dylanbailes/MPCTorqueControl/README.md

# SEA-MPC: torque control for a series-elastic actuator



A robotics controls project connecting mechanical compliance, system
identification, constrained model predictive control, and learned disturbance
compensation. A two-mass actuator model provides a reproducible environment
for comparing PID, MPC, and MPC with feedforward before hardware bring-up.

**Status:** simulation experiments and portable C control modules are
implemented. STM32 board integration and physical validation are in progress.
All results below are simulated; 2 kHz is the modeled torque-loop rate, not a
measured embedded execution rate. The firmware entry point is an integration
scaffold. See [remaining work](firmware/README.md).

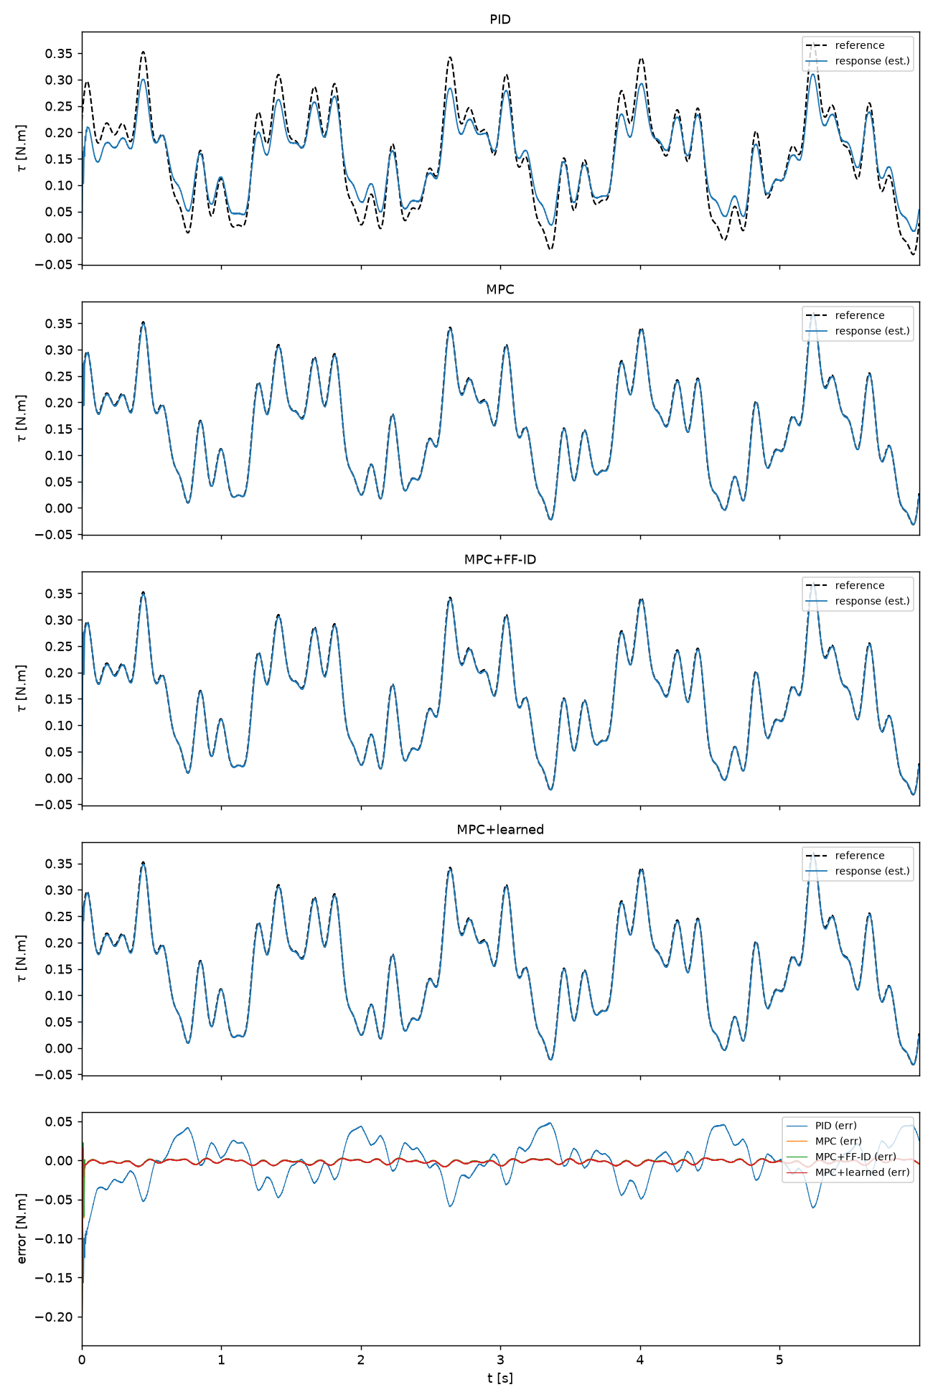
[picture p1: results/plots/tracking_smooth.png]
Simulated torque tracking for PID, MPC, and learned feedforward


## What the project demonstrates

- **Mechanical modeling:** a motor and load coupled by a torsion spring,
  with torque estimated from differential deflection.
- **Control design:** exact discretization, condensed MPC, current and
  first-command slew constraints, and a warm-started ADMM solver.
- **Identification:** spring calibration, integrated least squares, and a
  frequency-domain inertia cross-check.
- **Learning:** a compact residual model with causal lag features, held-out
  evaluation, and comparison against simpler friction compensation.
- **Embedded implementation:** portable C control modules and generated
  model constants, checked against the Python implementation on a host.

```text
torque reference -> PID / MPC -> optional feedforward -> current command
                                                        |
                         motor -> torsion spring -> load
                           |                       |
                           +--- angle feedback ----+
                              torque = ks * (θm - θl)
```

## Simulation results

The published experiment uses the selected 4015 motor parameter scenario
and a blocked-output fixture. [Results and limitations](docs/RESULTS.md)
define the measurement windows, configuration, and comparison conditions.
The table comes from [results/results.json](results/results.json).

<!-- RESULTS_TABLE_START -->
| Metric [mN·m] | PID | MPC | MPC + learned FF |
|---|---:|---:|---:|
| Smooth tracking RMS, latter half | 24.77 | 2.98 | 2.98 |
| Smooth tracking RMS, full run | 27.32 | 7.10 | 6.76 |
| Edge-rich tracking RMS, full run | 32.86 | 10.66 | 10.17 |
| Disturbance mean absolute error, steady window | 9.61 | 1.79 | 1.17 |
<!-- RESULTS_TABLE_END -->

The principal result is the improvement from model-based torque control.
Learned feedforward is an experiment: its benefit depends on the reference,
model error, and available current authority. A high residual-model R² does
not establish hardware performance or safe human interaction.

## Run it locally

Use Python 3.11 or 3.12 from the repository root. For the exact Python 3.12
environment used for the published snapshot, install `requirements-lock.txt`
instead of `requirements.txt`.

```bash
python -m venv .venv
# macOS / Linux:
source .venv/bin/activate
# Windows PowerShell: .\.venv\Scripts\Activate.ps1
python -m pip install -r requirements.txt
python -m pytest -q
python hardware/spring_design.py
```

Tests include host C compilation and Python/C MPC comparisons when GCC or
Clang is available. These checks run in GitHub Actions; without a local C
compiler they are explicitly skipped. Set `CC` to select a compiler.

Reproduce the published 4015 scenario (allow several minutes):

```bash
python -m sim.run_experiments --r 4.8 --l 0.0026 --kt 0.1562 --jm 0.00003 --u-max 3 --n 30 --out-dir results/scratch/4015
```

The default command runs a separate nominal plant scenario. `--fast`
shortens the experiments and produces different metrics. Scratch outputs
are ignored so exploratory runs do not overwrite the published evidence.
See [the results guide](results/README.md) for exports and provenance.
Website-ready charts in PNG/SVG, with light and dark themes, are available in
[the visuals gallery](results/website/README.md).

## Read the implementation

| Location | Purpose |
|---|---|
| [model/mpc.py](model/mpc.py), [model/qp.py](model/qp.py) | Prediction model, constrained controller, solvers |
| [learn/system_id.py](learn/system_id.py) | Calibration and inertia identification |
| [learn/residual.py](learn/residual.py) | Residual fitting, causal history, C export |
| [sim/bench.py](sim/bench.py) | Shared experiment harness and current budget |
| [test/](test/) | Numerical, control, and host firmware regression tests |
| [firmware/](firmware/README.md) | STM32 control modules and integration gaps |
| [hardware/](hardware/README.md) | Spring sizing, planned parts, CAD references |
| [model/matlab/](model/matlab/README.md) | Independent MATLAB formulations |

Start with [the design](docs/DESIGN.md), then inspect the controller and
[the results](docs/RESULTS.md). [Current limitations and next steps](docs/STATUS.md)
separate completed work from planned validation. The [16-week build plan](docs/plan/README.md)
and [research proposal](docs/PAPER_PITCH.md) are supporting planning documents.

## Contributing and license

See [CONTRIBUTING.md](CONTRIBUTING.md) for verification and experiment changes.
Original code and documentation use the [MIT license](LICENSE).
[Third-party material](THIRD_PARTY.md) retains its own terms; downloaded CAD
references are excluded from the public source.
See [the public-release review](docs/PUBLIC_RELEASE.md) for completed checks
and the remaining publication steps.
