dylanbailes/MPCTorqueControl/hardware/cad/inertial_disk/as_modeled/recommended_sweep.csv

config | radius_mm | A_per_face | B_per_face | mass_washer_count | retention_kits | carrier_weights_kits_mass_g | max_grip_mm | J_estimate_kg_m2 | locked_motor_load_mode_hz
BARE | 0 | 0 | 0 | 0 | 0 | 26.145306700259816 | 14.0 | 2.631584639114005e-05 | 31.024976434155906
R25-S00 | 25 | 0 | 0 | 0 | 8 | 106.14530670025982 | 14.0 | 7.631584639114005e-05 | 18.218506380332695
R25-S01 | 25 | 1 | 0 | 8 | 8 | 128.66844000897666 | 17.2 | 9.141312832633971e-05 | 16.646228271465326
R25-S02 | 25 | 1 | 1 | 16 | 8 | 151.19157331769347 | 17.2 | 0.00010651041026153936 | 15.421410682794399
R25-S03 | 25 | 2 | 1 | 24 | 8 | 173.7147066264103 | 20.4 | 0.000121607692196739 | 14.432434934911253
R25-S04 | 25 | 2 | 2 | 32 | 8 | 196.23783993512717 | 20.4 | 0.00013670497413193866 | 13.612189082800725
R25-S05 | 25 | 3 | 2 | 40 | 8 | 218.76097324384398 | 23.6 | 0.0001518022560671383 | 12.917575799038481
R25-S06 | 25 | 3 | 3 | 48 | 8 | 241.28410655256084 | 23.6 | 0.00016689953800233797 | 12.319485320460918
R25-S07 | 25 | 4 | 3 | 56 | 8 | 263.80723986127765 | 26.8 | 0.00018199681993753762 | 11.797452349140194
R25-S08 | 25 | 4 | 4 | 64 | 8 | 286.3303731699945 | 26.8 | 0.00019709410187273728 | 11.336612904210384
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
