dylanbailes/MPCTorqueControl/hardware/cad/inertial_disk/as_modeled/run_manifest.csv

run_id | repeat_block | config | A_per_face | B_per_face | radius_mm | J_estimate_kg_m2 | J_identified_kg_m2 | controller_mode | excitation_id | temperature_C | data_filename | notes
as_modeled-001 | 1 | R25-S05 | 3 | 2 | 25 | 0.0001518022560671383
as_modeled-002 | 1 | R25-S13 | 7 | 6 | 25 | 0.0002725805115487355
as_modeled-003 | 1 | R25-S12 | 6 | 6 | 25 | 0.0002574832296135359
as_modeled-004 | 1 | R25-S10 | 5 | 5 | 25 | 0.00022728866574313659
as_modeled-005 | 1 | R25-S03 | 2 | 1 | 25 | 0.000121607692196739
as_modeled-006 | 1 | R25-S19 | 10 | 9 | 25 | 0.00036316420315993345
as_modeled-007 | 1 | R25-S00 | 0 | 0 | 25 | 7.631584639114005e-05
as_modeled-008 | 1 | R25-S21 | 11 | 10 | 25 | 0.00039335876703033276
as_modeled-009 | 1 | R25-S18 | 9 | 9 | 25 | 0.00034806692122473377
as_modeled-010 | 1 | R25-S01 | 1 | 0 | 25 | 9.141312832633971e-05
as_modeled-011 | 1 | R25-S22 | 11 | 11 | 25 | 0.0004084560489655324
as_modeled-012 | 1 | R25-S14 | 7 | 7 | 25 | 0.0002876777934839352
as_modeled-013 | 1 | R25-S23 | 12 | 11 | 25 | 0.00042355333090073207
as_modeled-014 | 1 | R25-S02 | 1 | 1 | 25 | 0.00010651041026153936
as_modeled-015 | 1 | R25-S15 | 8 | 7 | 25 | 0.00030277507541913483
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
