dylanbailes/MPCTorqueControl/hardware/cad/inertial_disk/compact/recommended_sweep.csv

config | radius_mm | A_per_face | B_per_face | mass_washer_count | retention_kits | carrier_weights_kits_mass_g | max_grip_mm | J_estimate_kg_m2 | locked_motor_load_mode_hz
BARE | 0 | 0 | 0 | 0 | 0 | 17.8714951904302 | 12.0 | 2.2119203033450878e-05 | 33.84039269675885
R26-S00 | 26 | 0 | 0 | 0 | 8 | 97.8714951904302 | 12.0 | 7.619920303345087e-05 | 18.23244520808121
R26-S01 | 26 | 1 | 0 | 8 | 8 | 120.39462849914703 | 15.2 | 9.244516476739508e-05 | 16.55305016543145
R26-S02 | 26 | 1 | 1 | 16 | 8 | 142.91776180786385 | 15.2 | 0.00010869112650133928 | 15.265923674162806
R26-S03 | 26 | 2 | 1 | 24 | 8 | 165.44089511658072 | 18.4 | 0.0001249370882352835 | 14.238834480121575
R26-S04 | 26 | 2 | 2 | 32 | 8 | 187.96402842529753 | 18.4 | 0.0001411830499692277 | 13.394572331333324
R26-S05 | 26 | 3 | 2 | 40 | 8 | 210.4871617340144 | 21.6 | 0.0001574290117031719 | 12.684628345897083
R26-S06 | 26 | 3 | 3 | 48 | 8 | 233.0102950427312 | 21.6 | 0.0001736749734371161 | 12.07678990385074
R26-S07 | 26 | 4 | 3 | 56 | 8 | 255.53342835144804 | 24.8 | 0.00018992093517106033 | 11.548716267677774
R26-S08 | 26 | 4 | 4 | 64 | 8 | 278.0565616601649 | 24.8 | 0.0002061668969050045 | 11.084361073953405
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
