dylanbailes/MPCTorqueControl/hardware/cad/inertial_disk/compact/run_manifest.csv

run_id | repeat_block | config | A_per_face | B_per_face | radius_mm | J_estimate_kg_m2 | J_identified_kg_m2 | controller_mode | excitation_id | temperature_C | data_filename | notes
compact-001 | 1 | R26-S05 | 3 | 2 | 26 | 0.0001574290117031719
compact-002 | 1 | R26-S13 | 7 | 6 | 26 | 0.00028739670557472553
compact-003 | 1 | R26-S12 | 6 | 6 | 26 | 0.00027115074384078135
compact-004 | 1 | R26-S10 | 5 | 5 | 26 | 0.00023865882037289293
compact-005 | 1 | R26-S03 | 2 | 1 | 26 | 0.0001249370882352835
compact-006 | 1 | R26-S19 | 10 | 9 | 26 | 0.0003848724759783908
compact-007 | 1 | R26-S00 | 0 | 0 | 26 | 7.619920303345087e-05
compact-008 | 1 | R26-S21 | 11 | 10 | 26 | 0.0004173643994462792
compact-009 | 1 | R26-S18 | 9 | 9 | 26 | 0.0003686265142444466
compact-010 | 1 | R26-S01 | 1 | 0 | 26 | 9.244516476739508e-05
compact-011 | 1 | R26-S22 | 11 | 11 | 26 | 0.00043361036118022344
compact-012 | 1 | R26-S14 | 7 | 7 | 26 | 0.00030364266730866977
compact-013 | 1 | R26-S23 | 12 | 11 | 26 | 0.0004498563229141676
compact-014 | 1 | R26-S02 | 1 | 1 | 26 | 0.00010869112650133928
compact-015 | 1 | R26-S15 | 8 | 7 | 26 | 0.00031988862904261395
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
