dylanbailes/MPCTorqueControl/hardware/cad/inertial_disk/raised/configurations.csv

config | radius_mm | A_per_face | B_per_face | mass_washer_count | retention_kits | carrier_weights_kits_mass_g | max_grip_mm | J_estimate_kg_m2 | locked_motor_load_mode_hz
BARE | 0 | 0 | 0 | 0 | 0 | 142.0898475452478 | 12 | 0.0007049929901880421 | 5.994151732806155
R40-S00 | 40 | 0 | 0 | 0 | 8 | 222.0898475452478 | 12 | 0.0008329929901880421 | 5.51441514525407
R40-S01 | 40 | 1 | 0 | 8 | 8 | 272.5571961802336 | 16 | 0.0009177769163930155 | 5.253534232518161
R40-S02 | 40 | 1 | 1 | 16 | 8 | 323.0245448152193 | 16 | 0.001002560842597989 | 5.026489301631374
R40-S03 | 40 | 2 | 1 | 24 | 8 | 373.49189345020505 | 20 | 0.0010873447688029623 | 4.826546525485291
R40-S04 | 40 | 2 | 2 | 32 | 8 | 423.9592420851908 | 20 | 0.001172128695007936 | 4.648710300996356
R40-S05 | 40 | 3 | 2 | 40 | 8 | 474.4265907201766 | 24 | 0.0012569126212129092 | 4.489185877906412
R40-S06 | 40 | 3 | 3 | 48 | 8 | 524.8939393551624 | 24 | 0.0013416965474178826 | 4.345032012789542
R40-S07 | 40 | 4 | 3 | 56 | 8 | 575.3612879901481 | 28 | 0.0014264804736228561 | 4.213929020263651
R40-S08 | 40 | 4 | 4 | 64 | 8 | 625.8286366251338 | 28 | 0.0015112643998278295 | 4.094019488226837
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
