dylanbailes/MPCTorqueControl/hardware/cad/inertial_disk/raised/run_manifest.csv

run_id | repeat_block | config | A_per_face | B_per_face | radius_mm | J_estimate_kg_m2 | J_identified_kg_m2 | controller_mode | excitation_id | temperature_C | data_filename | notes
raised-001 | 1 | R80-S02 | 1 | 1 | 80 | 0.0018710473894938523
raised-002 | 1 | R80-S07 | 4 | 3 | 80 | 0.0035061833877583774
raised-003 | 1 | R40-S00 | 0 | 0 | 40 | 0.0008329929901880421
raised-004 | 1 | R40-S02 | 1 | 1 | 40 | 0.001002560842597989
raised-005 | 1 | R40-S05 | 3 | 2 | 40 | 0.0012569126212129092
raised-006 | 1 | R80-S00 | 0 | 0 | 80 | 0.0012169929901880423
raised-007 | 1 | R52-S04 | 2 | 2 | 52 | 0.0014833125065800328
raised-008 | 1 | R52-S05 | 3 | 2 | 52 | 0.0016238123856780306
raised-009 | 1 | R40-S03 | 2 | 1 | 40 | 0.0010873447688029623
raised-010 | 1 | R80-S03 | 2 | 1 | 80 | 0.0021980745891467574
raised-011 | 1 | R80-S05 | 3 | 2 | 80 | 0.0028521289884525674
raised-012 | 1 | R52-S01 | 1 | 0 | 52 | 0.0010618128692860397
raised-013 | 1 | R52-S03 | 2 | 1 | 52 | 0.0013428126274820352
raised-014 | 1 | R40-S01 | 1 | 0 | 40 | 0.0009177769163930155
raised-015 | 1 | R52-S06 | 3 | 3 | 52 | 0.0017643122647760282
raised-016 | 1 | R80-S01 | 1 | 0 | 80 | 0.0015440201898409473
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
