dylanbailes/MPCTorqueControl/hardware/cad/inertial_disk/as_modeled/design_reference.png

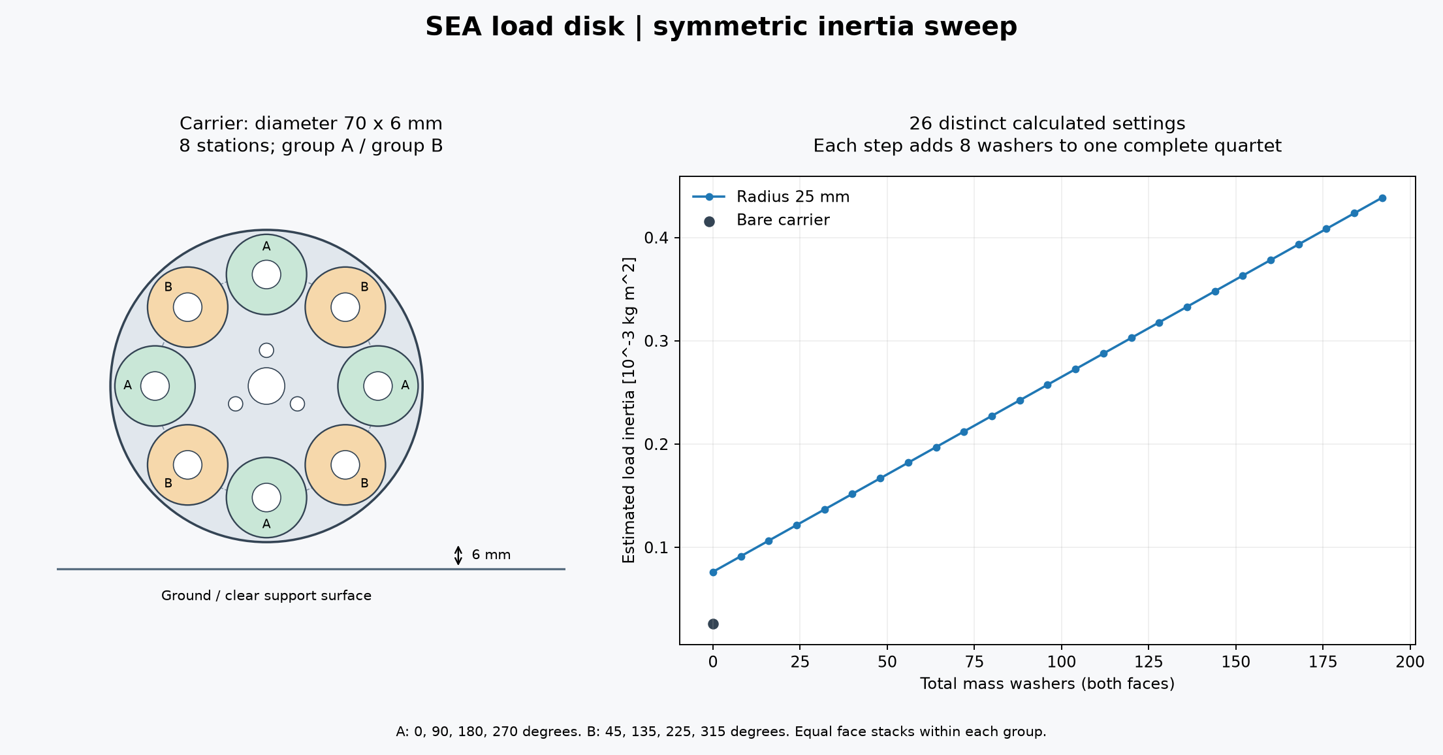
hardware/cad/inertial_disk/as_modeled/design_reference.png
