dylanbailes/MPCTorqueControl/hardware/cad/inertial_disk/raised/design_reference.png

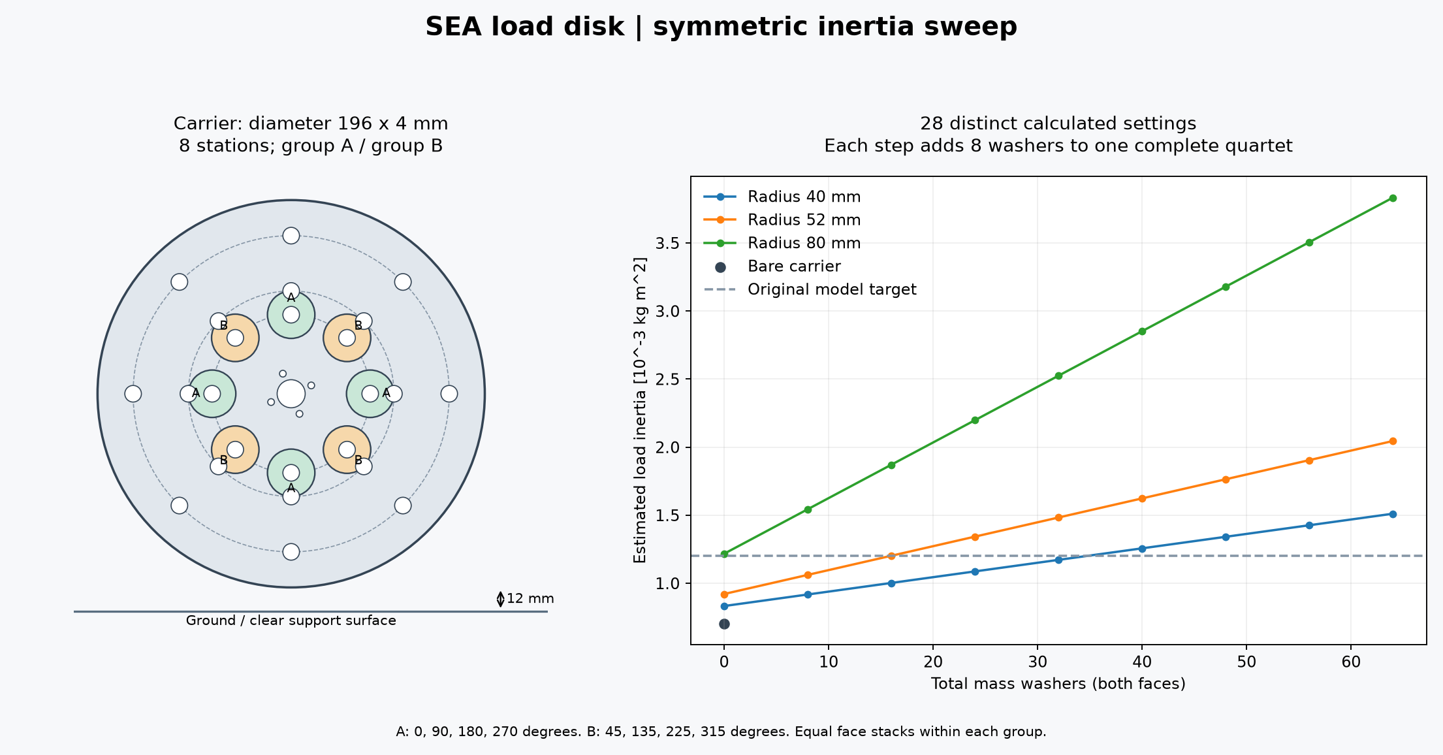
hardware/cad/inertial_disk/raised/design_reference.png
