dylanbailes/MPCTorqueControl/hardware/cad/custom/step/bearing_block.step

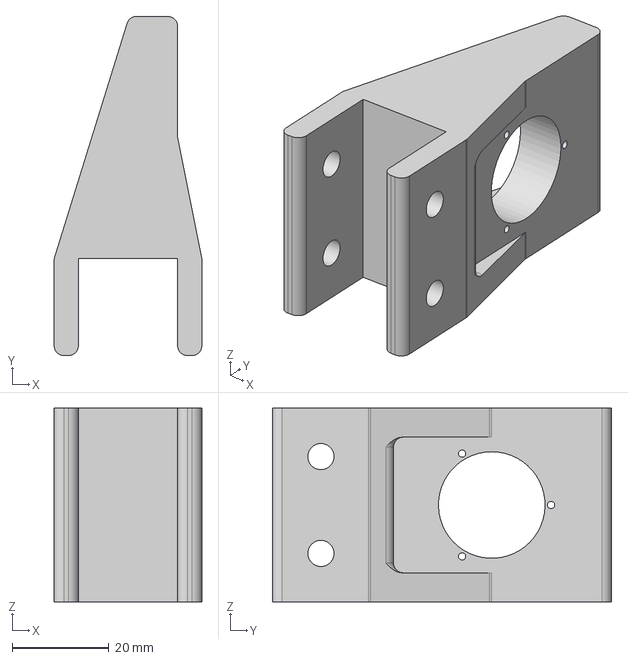
[picture p5: CAD file, 2026-10-08]
hardware/cad/custom/step/bearing_block.step
30.5 x 70.0 x 40.0 mm
