dylanbailes/MPCTorqueControl/hardware/cad/custom/stl/extrusion_bracket_body_1.stl

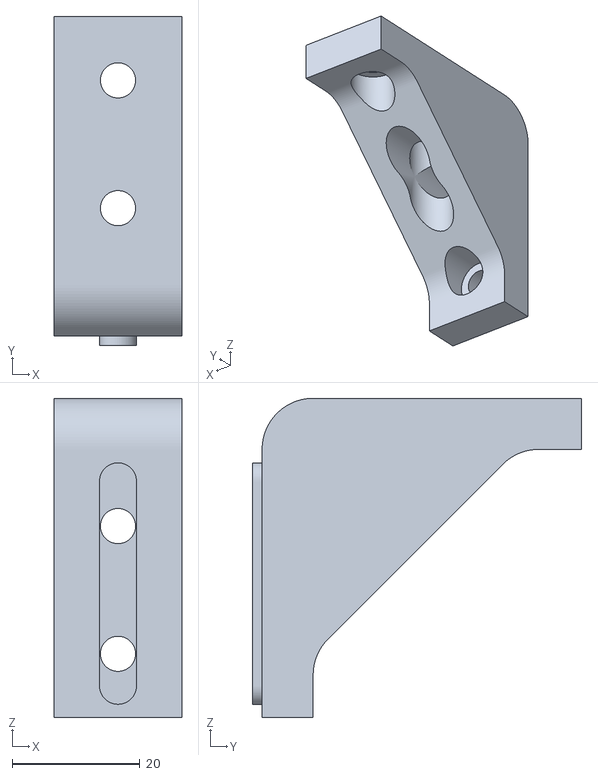
[picture p6: CAD file, 2026-10-08]
hardware/cad/custom/stl/extrusion_bracket_body_1.stl
20.0 x 51.5 x 50.0
