dylanbailes/MPCTorqueControl/hardware/cad/inertial_disk/as_modeled/carrier_reference.dxf

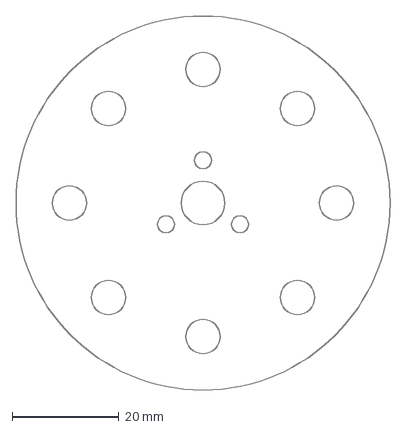
[picture p7: CAD file, 2026-10-08]
hardware/cad/inertial_disk/as_modeled/carrier_reference.dxf
70.0 x 70.0 mm
