dylanbailes/MPCTorqueControl/hardware/cad/inertial_disk/compact/carrier_reference.dxf

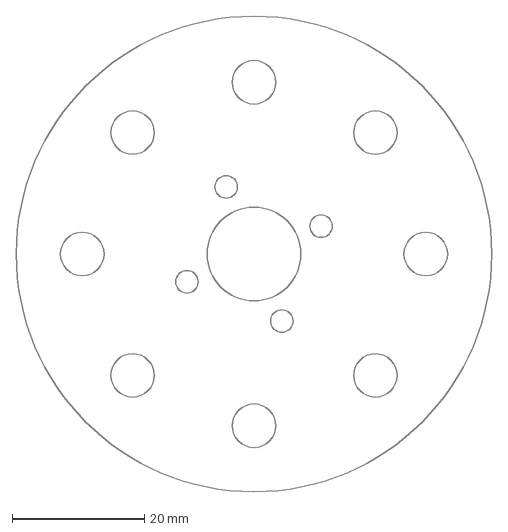
[picture p8: CAD file, 2026-10-08]
hardware/cad/inertial_disk/compact/carrier_reference.dxf
72.0 x 72.0 mm
