dylanbailes/MPCTorqueControl/hardware/cad/inertial_disk/raised/carrier_reference.dxf

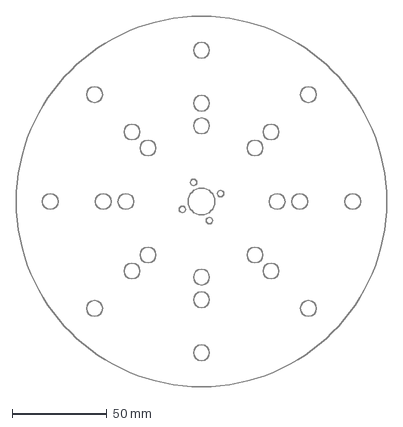
[picture p9: CAD file, 2026-10-08]
hardware/cad/inertial_disk/raised/carrier_reference.dxf
196.0 x 196.0 mm
