dylanbailes/MPCTorqueControl/hardware/cad/custom/step/load_hub.step

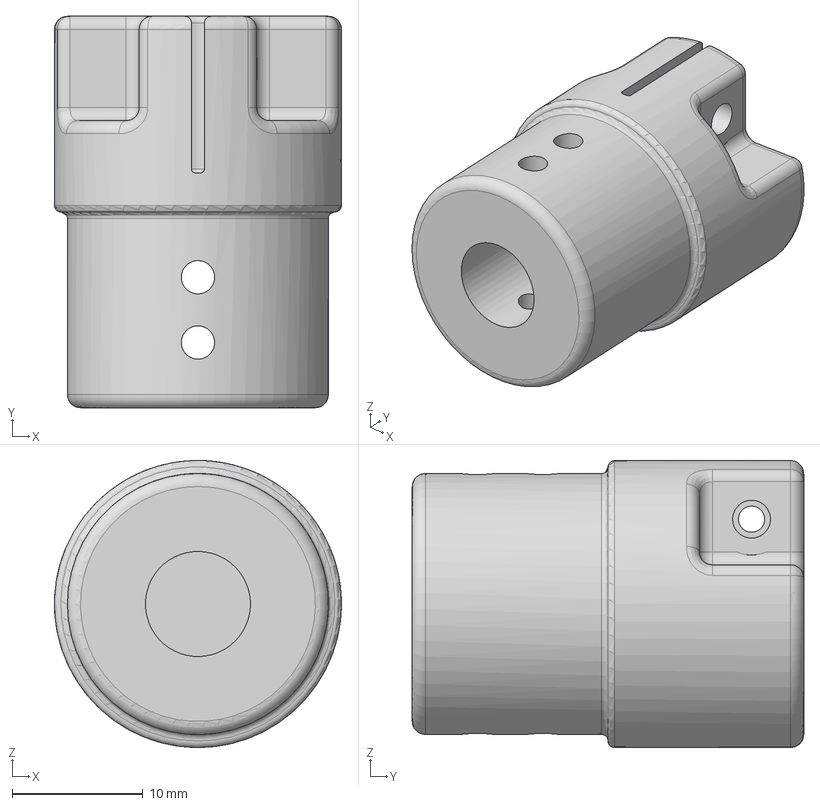
[picture p10: CAD file, 2026-10-08]
hardware/cad/custom/step/load_hub.step
22.0 x 30.0 x 22.0 mm
