dylanbailes/MPCTorqueControl/hardware/cad/custom/stl/extrusion_bracket_body_2.stl

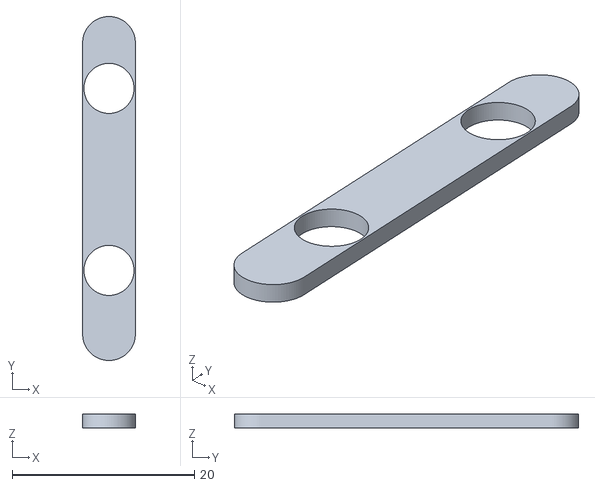
[picture p11: CAD file, 2026-10-08]
hardware/cad/custom/stl/extrusion_bracket_body_2.stl
5.80 x 37.8 x 1.50
