dylanbailes/MPCTorqueControl/hardware/cad/custom/step/extrusion_bracket.step

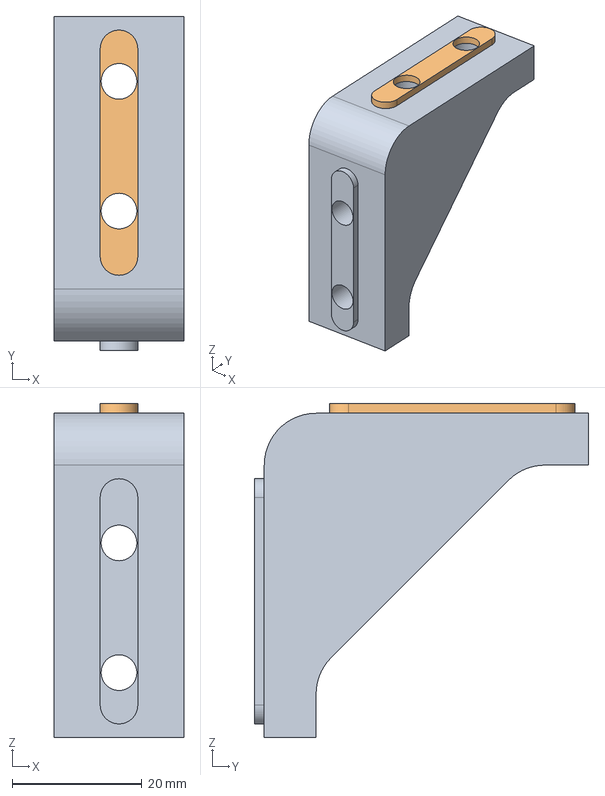
[picture p12: CAD file, 2026-10-08]
hardware/cad/custom/step/extrusion_bracket.step
20.0 x 51.5 x 51.5 mm
