dylanbailes/MPCTorqueControl/hardware/cad/custom/step/torsion_bar.step

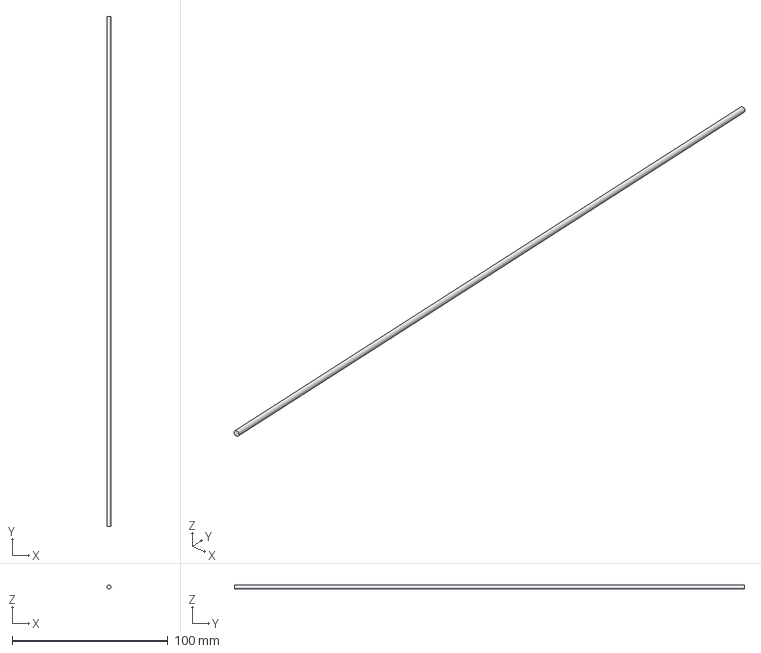
[picture p13: CAD file, 2026-10-08]
hardware/cad/custom/step/torsion_bar.step
2.50 x 327.0 x 2.50 mm
