dylanbailes/MPCTorqueControl/hardware/cad/custom/step/load_shaft_8mm.step

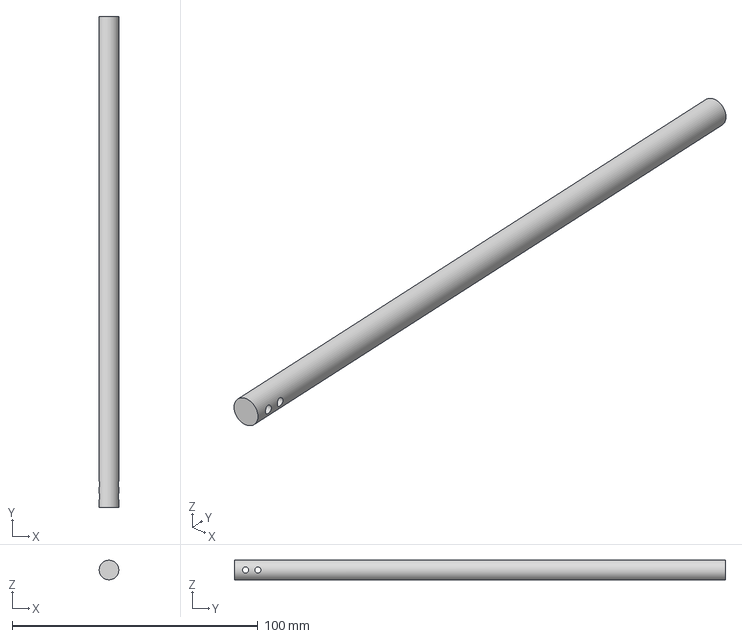
[picture p14: CAD file, 2026-10-08]
hardware/cad/custom/step/load_shaft_8mm.step
8.00 x 200.0 x 8.00 mm
