dylanbailes/MPCTorqueControl/hardware/cad/custom/step/motor_hub.step

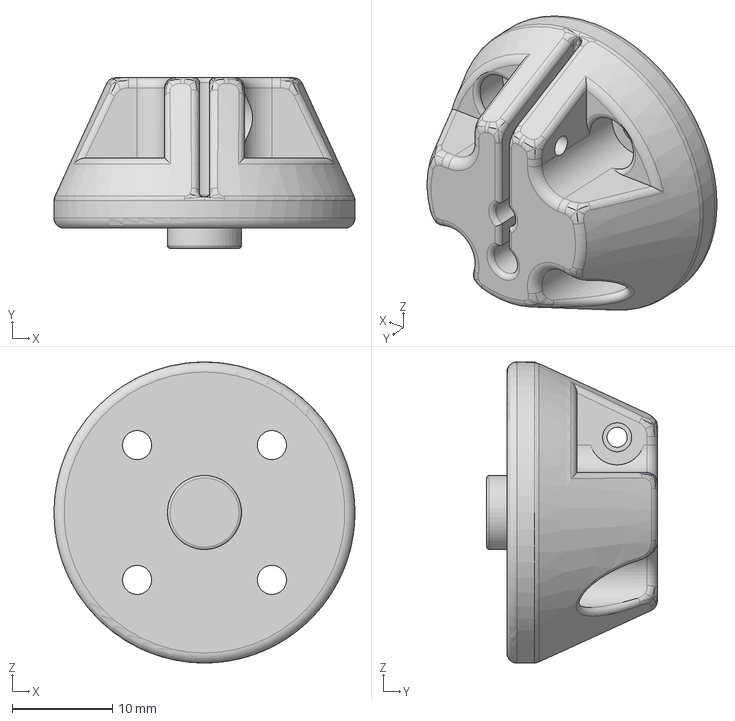
[picture p15: CAD file, 2026-10-08]
hardware/cad/custom/step/motor_hub.step
30.0 x 17.0 x 30.0 mm
