dylanbailes/MPCTorqueControl/hardware/cad/custom/step/motor_mount.step

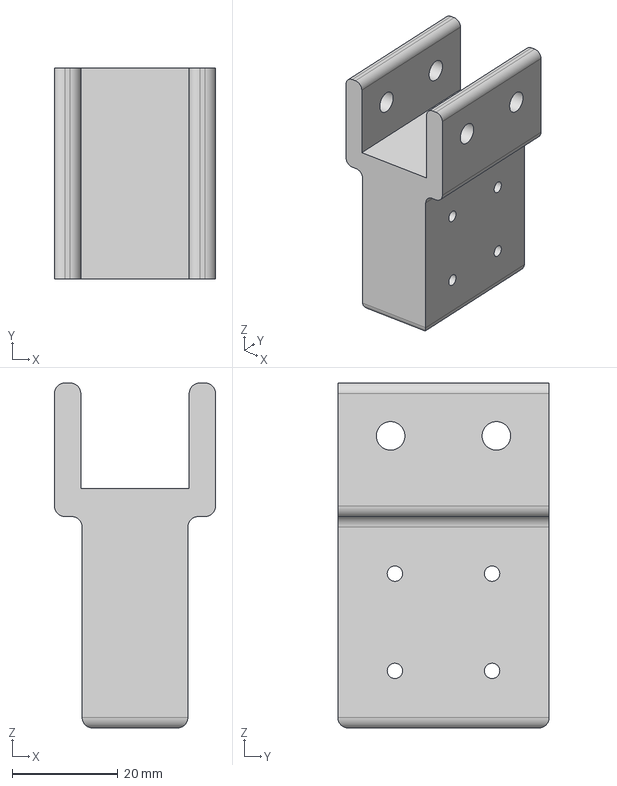
[picture p16: CAD file, 2026-10-08]
hardware/cad/custom/step/motor_mount.step
30.5 x 40.0 x 65.3 mm
