dylanbailes/MPCTorqueControl/hardware/cad/custom/step/inertial_disk.step

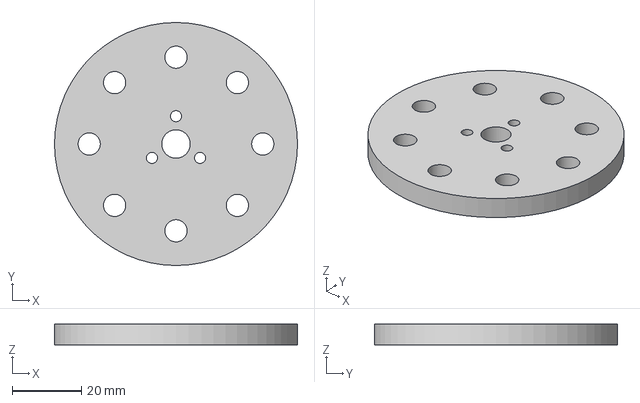
[picture p17: CAD file, 2026-10-08]
hardware/cad/custom/step/inertial_disk.step
70.0 x 70.0 x 6.00 mm
