dylanbailes/MPCTorqueControl/(list of files, cad)

Other CAD files:
hardware/cad/custom/fusion/bearing_block.f3d
hardware/cad/custom/fusion/extrusion_bracket.f3d
hardware/cad/custom/fusion/inertial_disk.f3d
hardware/cad/custom/fusion/load_hub.f3d
hardware/cad/custom/fusion/load_shaft_8mm.f3d
hardware/cad/custom/fusion/motor_hub.f3d
hardware/cad/custom/fusion/motor_mount.f3d
hardware/cad/custom/fusion/torsion_bar.f3d
hardware/cad/custom/stl/bearing_block.stl
hardware/cad/custom/stl/inertial_disk.stl
hardware/cad/custom/stl/load_hub.stl
hardware/cad/custom/stl/motor_hub.stl
hardware/cad/custom/stl/motor_mount.stl
