dylanbailes/MPCTorqueControl/results/plots/tracking_comparison.png

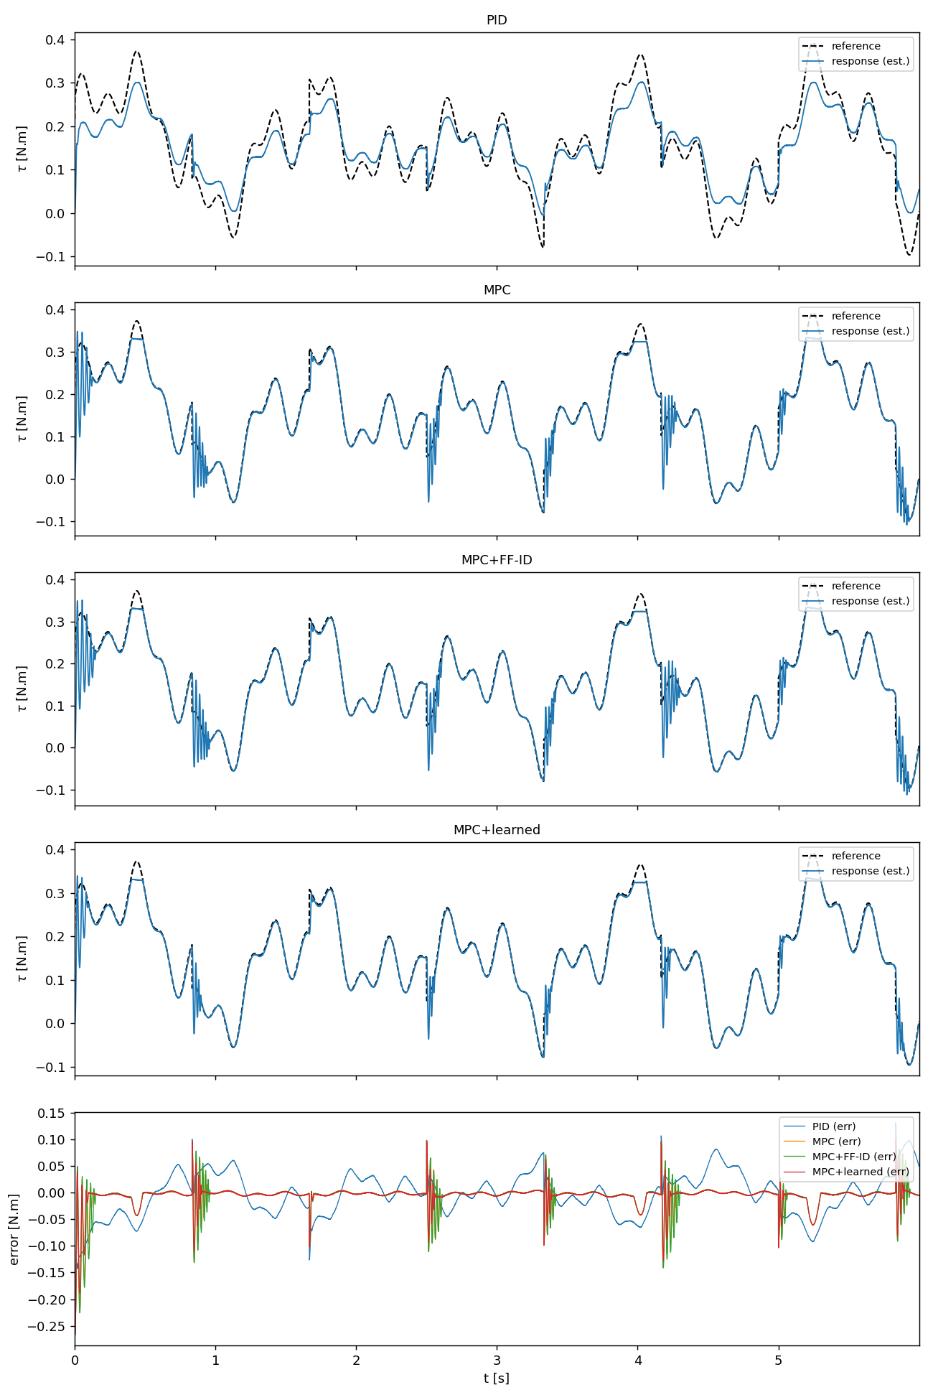
results/plots/tracking_comparison.png
