dylanbailes/MPCTorqueControl/results/website/controller-comparison-dark.png

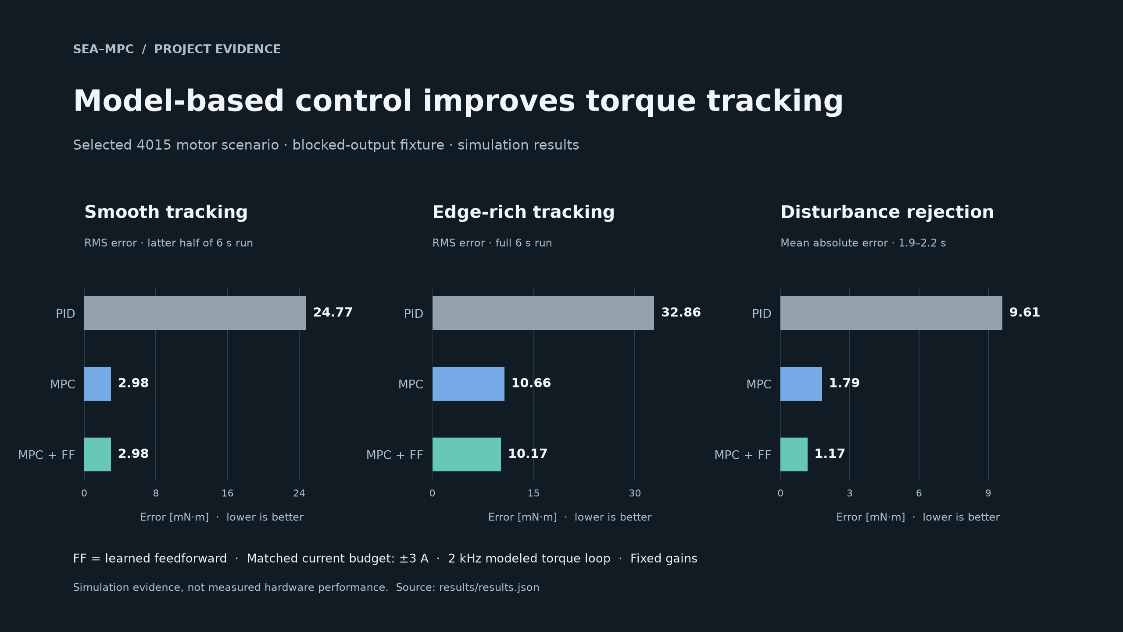
results/website/controller-comparison-dark.png
