dylanbailes/MPCTorqueControl/results/website/learned-feedforward-light.png

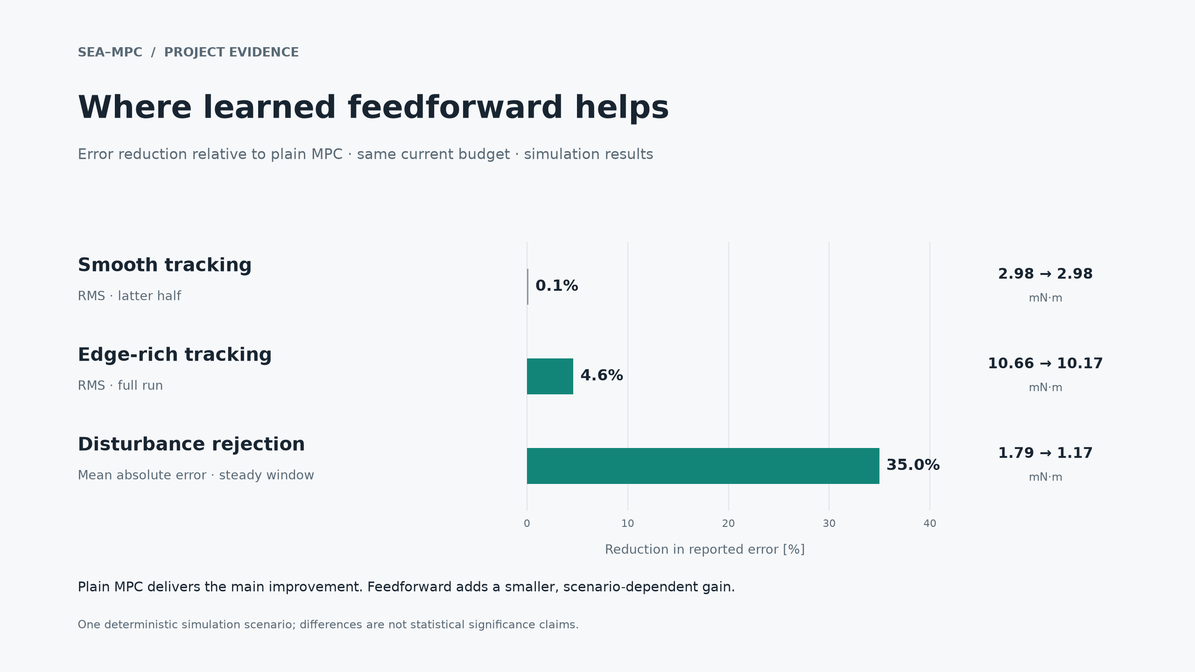
results/website/learned-feedforward-light.png
