dylanbailes/MPCTorqueControl/results/website/project-progress-dark.png

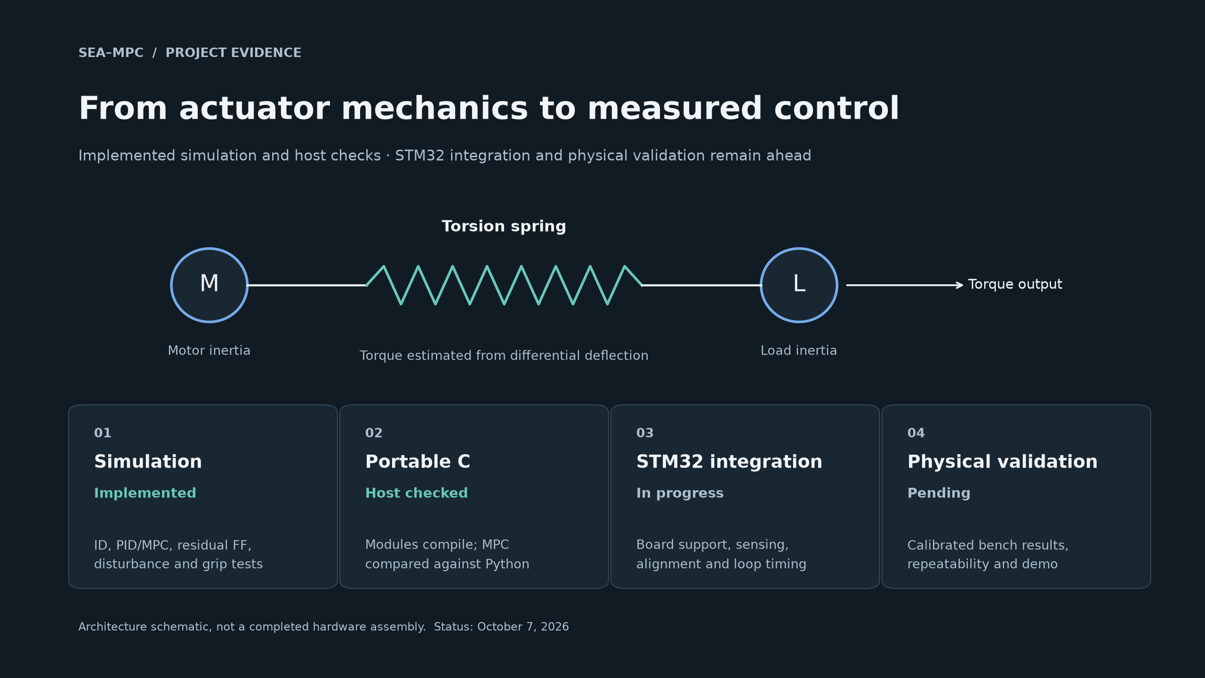
results/website/project-progress-dark.png
